HABP0705/Henry_Bautista_PLC4uni/Tarea 2/Diseño de plastico PLC4uni/Diseño parametrico en FreeCad/PLC4uni-209.FCStd

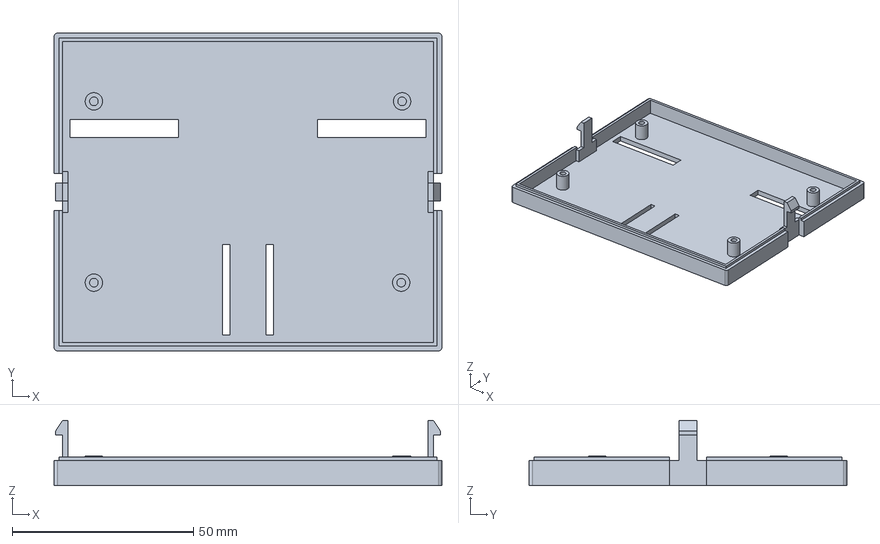
[picture p23: CAD file, 2025-09-25]
Tarea 2/Diseño de plastico PLC4uni/Diseño parametrico en FreeCad/PLC4uni-209.FCStd
107.0 x 87.7 x 18.0 mm
