HABP0705/Henry_Bautista_PLC4uni/Tarea 3/Archivos .DXF/PLC4uni-209.dxf

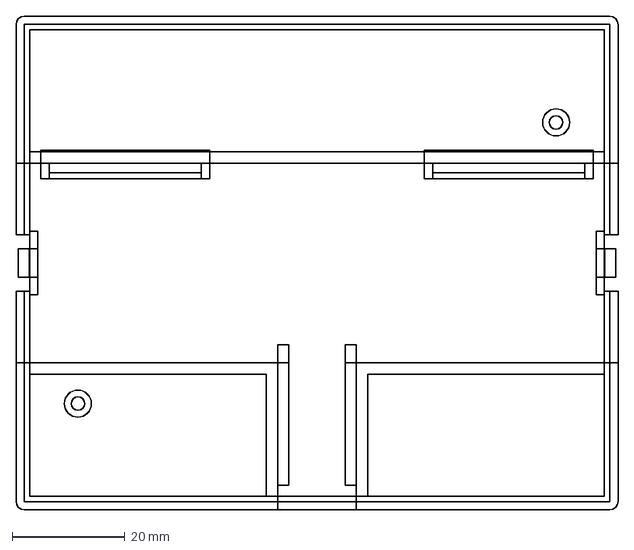
[picture p24: CAD file, 2025-10-06]
Tarea 3/Archivos .DXF/PLC4uni-209.dxf
107.0 x 87.7 mm
