HABP0705/Henry_Bautista_PLC4uni/Tarea 4/1.PCB principal de los conectores/PCB Vertical.DXF

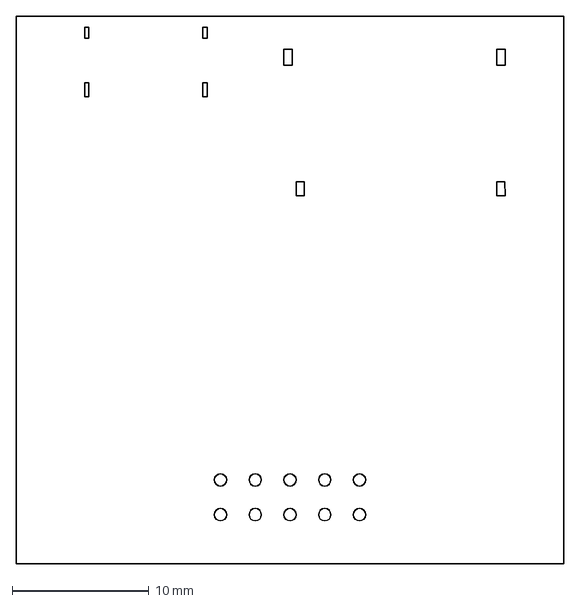
[picture p25: CAD file, 2025-12-02]
Tarea 4/1.PCB principal de los conectores/PCB Vertical.DXF
40.0 x 40.0 mm
