HABP0705/Henry_Bautista_PLC4uni/Tarea 4/2.USB Y SD CARD/USB Type C Port (SMD Type) (1)[1].STEP

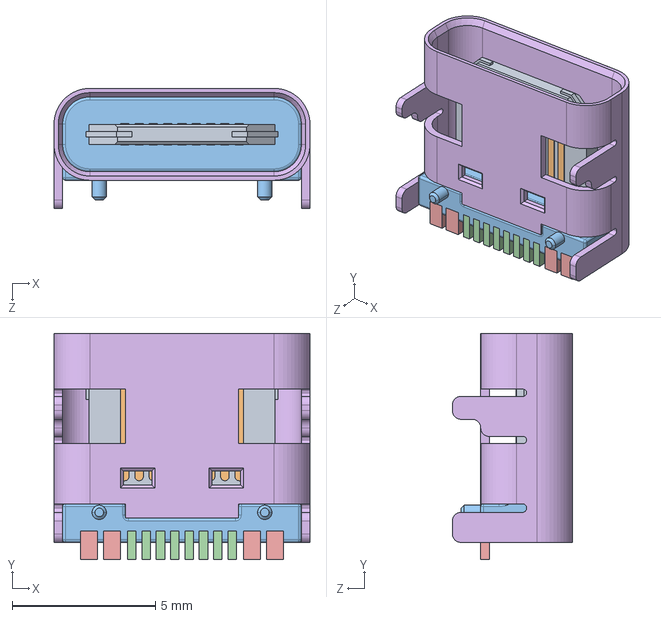
[picture p26: CAD file, 2025-12-02]
Tarea 4/2.USB Y SD CARD/USB Type C Port (SMD Type) (1)[1].STEP
8.94 x 7.90 x 4.20 mm
