HABP0705/Henry_Bautista_PLC4uni/Tarea 6/2.Conector USB y SD Card/Same_Sky_MSD-4-A.step

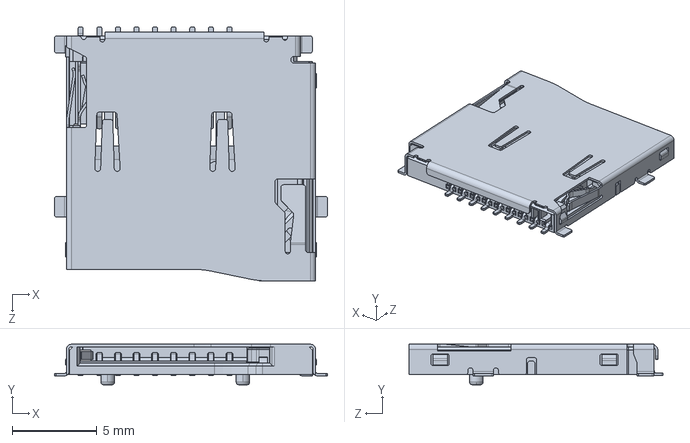
[picture p27: CAD file, 2025-12-02]
Tarea 6/2.Conector USB y SD Card/Same_Sky_MSD-4-A.step
16.1 x 2.40 x 15.0 mm
