HABP0705/Henry_Bautista_PLC4uni/Tarea 2/Diseño de plastico PLC4uni/Diseño parametrico en FreeCad/PLC4uni-208.FCStd

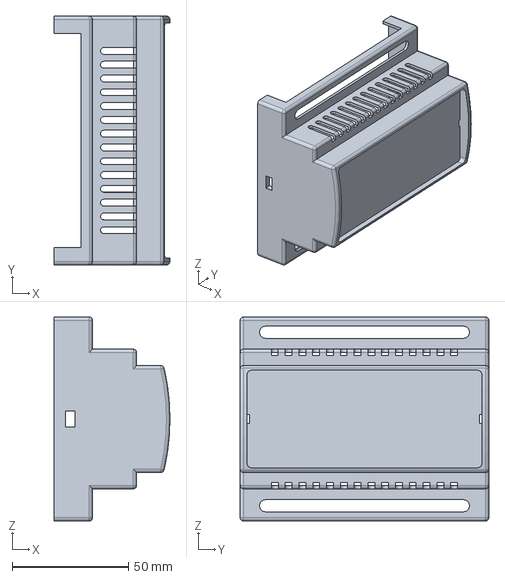
[picture p28: CAD file, 2025-09-24]
Tarea 2/Diseño de plastico PLC4uni/Diseño parametrico en FreeCad/PLC4uni-208.FCStd
49.8 x 107.0 x 87.7 mm
