HABP0705/Henry_Bautista_PLC4uni/Tarea 3/Archivos .DXF/PLC4uni-208.dxf

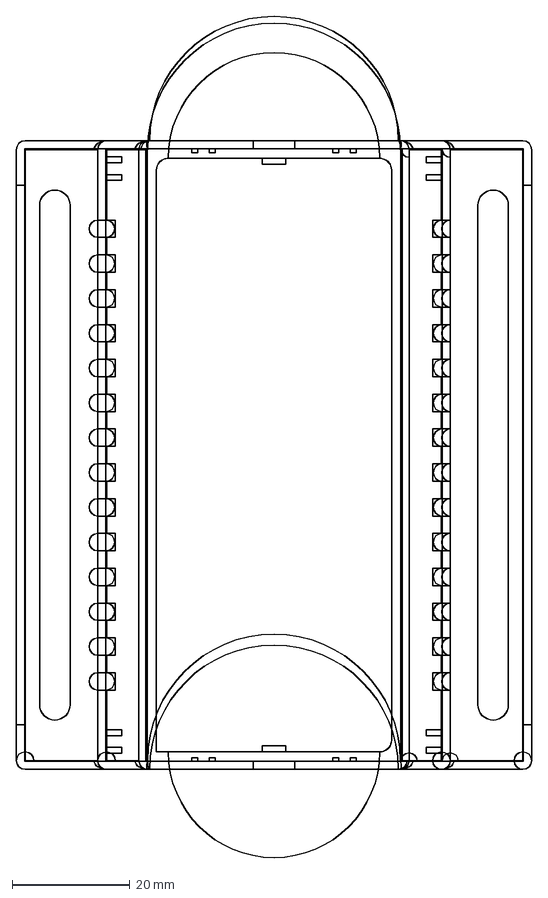
[picture p29: CAD file, 2025-10-06]
Tarea 3/Archivos .DXF/PLC4uni-208.dxf
87.7 x 143.2 mm
