HABP0705/Henry_Bautista_PLC4uni/Tarea 4/1.PCB principal de los conectores/2x5 Male Pin Header Angle.STEP

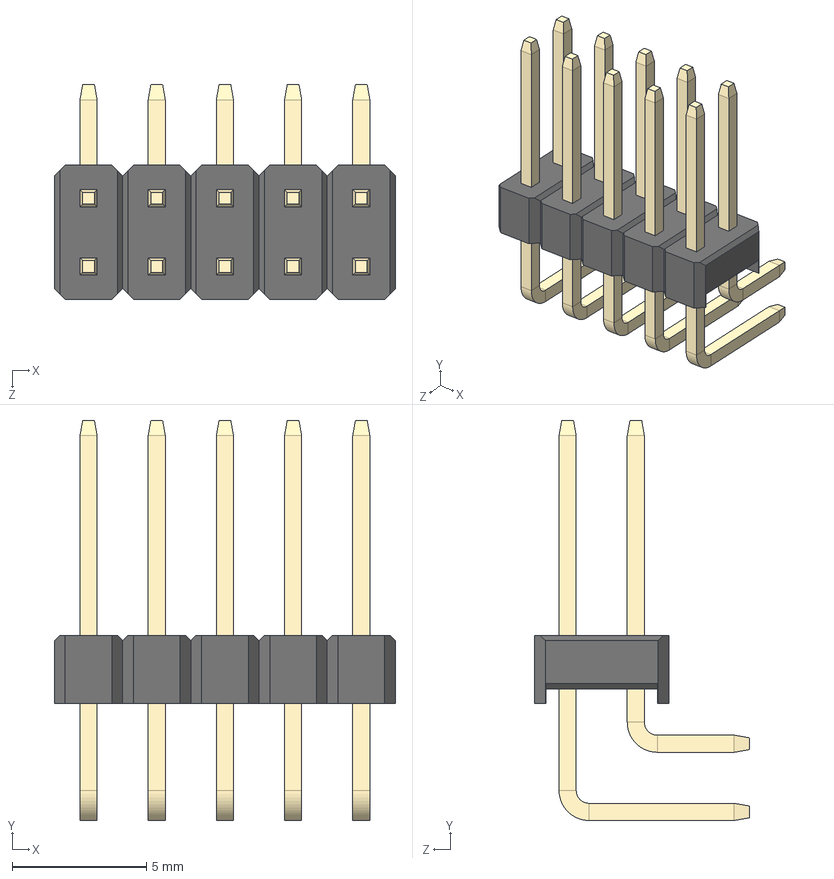
[picture p30: CAD file, 2025-12-02]
Tarea 4/1.PCB principal de los conectores/2x5 Male Pin Header Angle.STEP
12.7 x 14.9 x 8.00 mm
