HABP0705/Henry_Bautista_PLC4uni/Diseño del board/Diseños de circuitos/Diseños de circuitos.kicad_sch

## KiCad design Diseño del board/Diseños de circuitos/Diseños de circuitos.kicad_sch (2025-11-25, an earlier design)

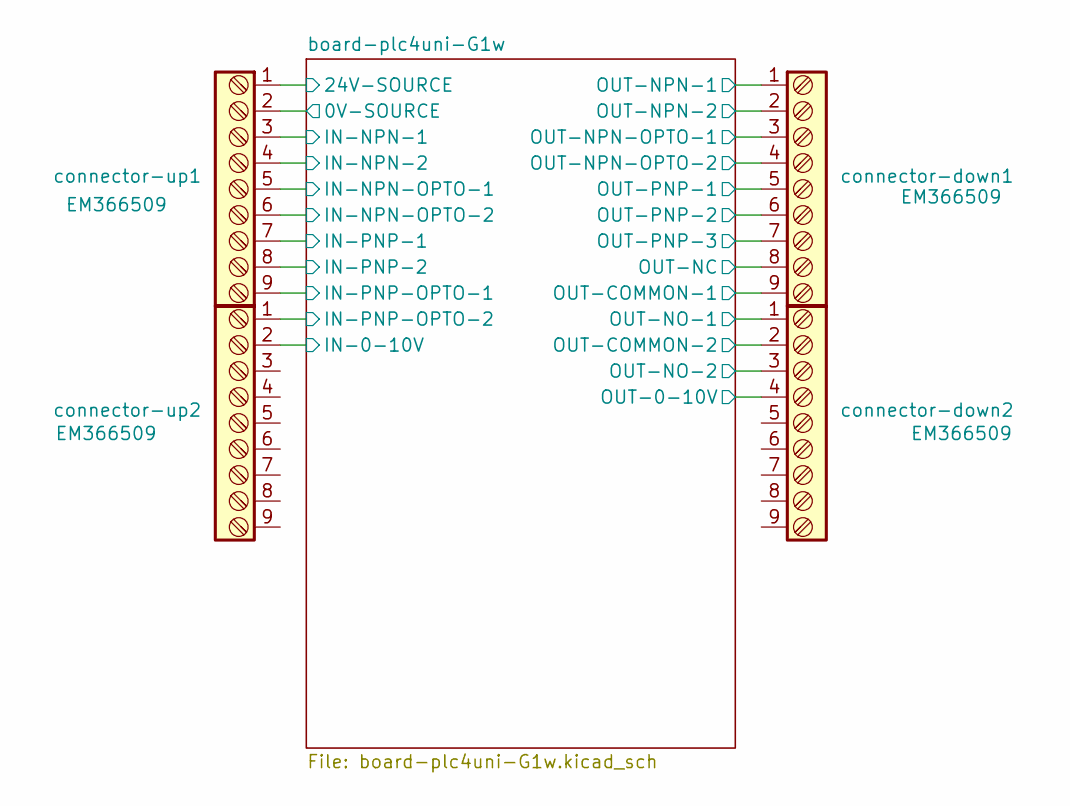
[picture p55: schematic Diseños de circuitos.kicad_sch]

Parts:
connector-down1, connector-down2: Screw_Terminal_9_P5.00mm; TerminalBlock_Phoenix_PT-1,5-9-5.0-H_1x09_P5.00mm_Horizontal; Part number EM366509
connector-up1, connector-up2: Screw_Terminal_9_P5.00mm; TerminalBlock_Phoenix_PT-1,5-9-5.0-H_1x09_P5.00mm_Horizontal; Part number EM366509

Connections:
0V-SOURCE: connector-up1.2
24V-SOURCE: connector-up1.1
IN-0-10V: connector-up2.2
IN-NPN-1: connector-up1.3
IN-NPN-2: connector-up1.4
IN-NPN-OPTO-1: connector-up1.5
IN-NPN-OPTO-2: connector-up1.6
IN-PNP-1: connector-up1.7
IN-PNP-2: connector-up1.8
IN-PNP-OPTO-1: connector-up1.9
IN-PNP-OPTO-2: connector-up2.1
OUT-0-10V: connector-down2.4
OUT-COMMON-1: connector-down1.9
OUT-COMMON-2: connector-down2.2
OUT-NC: connector-down1.8
OUT-NO-1: connector-down2.1
OUT-NO-2: connector-down2.3
OUT-NPN-1: connector-down1.1
OUT-NPN-2: connector-down1.2
OUT-NPN-OPTO-1: connector-down1.3
OUT-NPN-OPTO-2: connector-down1.4
OUT-PNP-1: connector-down1.5
OUT-PNP-2: connector-down1.6
OUT-PNP-3: connector-down1.7
