HABP0705/Henry_Bautista_PLC4uni/Diseño del board/Diseños de circuitos/INPUT-0-10V.kicad_sch

## KiCad design Diseño del board/Diseños de circuitos/INPUT-0-10V.kicad_sch (2025-11-13)

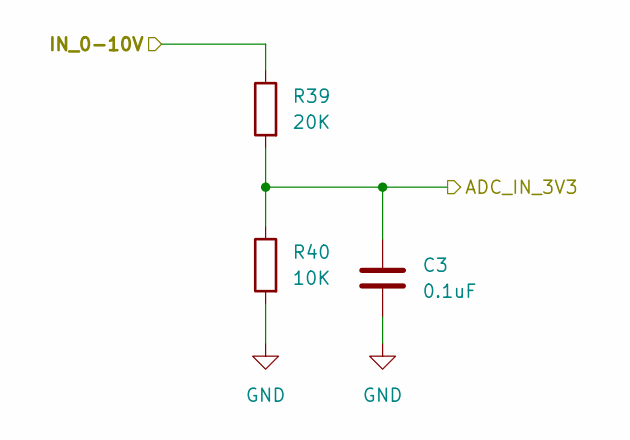
[picture p56: schematic INPUT-0-10V.kicad_sch]

Parts:
C3: 0.1uF; C_0201_0603Metric; LCSC C66501
R39: 20K; R_0603_1608Metric
R40: 10K; R_0603_1608Metric

Connections:
ADC_IN_3V3: C3.2, R39.1, R40.2
GND: C3.1, R40.1
IN_0-10V: R39.2
