HABP0705/Henry_Bautista_PLC4uni/Diseño del board/Diseños de circuitos/output-npn-opto.kicad_sch

## KiCad design Diseño del board/Diseños de circuitos/output-npn-opto.kicad_sch (2025-11-06)

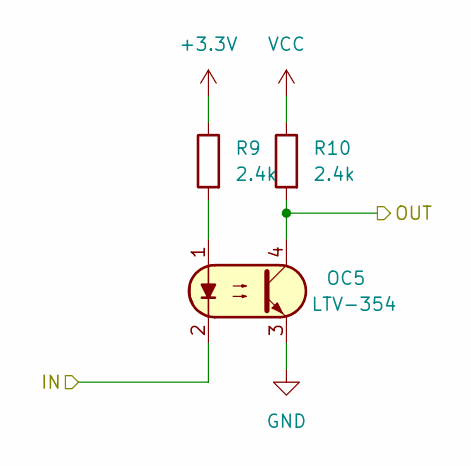
[picture p65: schematic output-npn-opto.kicad_sch]

Parts:
OC5: FOD817S; SMDIP-4_W9.53mm; Part Number LTV-354
R9, R10: 2.4k; R_0603_1608Metric

Connections:
+3.3V: R9.2
GND: OC5.3
IN: OC5.2
unnamed: OC5.1, R9.1
OUT: OC5.4, R10.1
VCC: R10.2
