HABP0705/Henry_Bautista_PLC4uni/Diseño del board/Diseños de circuitos/output-pnp.kicad_sch

## KiCad design Diseño del board/Diseños de circuitos/output-pnp.kicad_sch (2025-11-06)

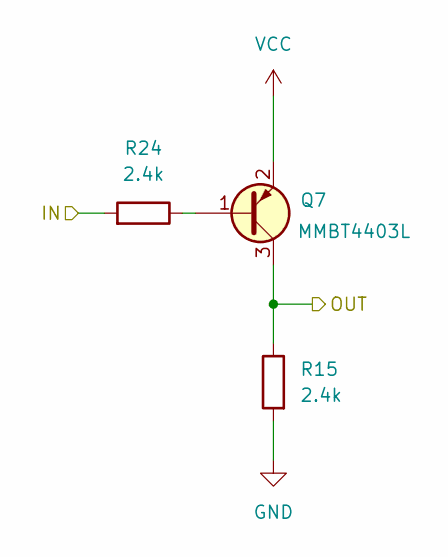
[picture p66: schematic output-pnp.kicad_sch]

Parts:
Q7: 2SA2018; SOT-416; Part number MMBT4403L
R15, R24: 2.4k; R_0603_1608Metric

Connections:
GND: R15.1
IN: R24.1
unnamed: Q7.1 (B), R24.2
OUT: Q7.3 (C), R15.2
VCC: Q7.2 (E)
