HABP0705/Henry_Bautista_PLC4uni/Diseño del board/Diseños de circuitos/source protection.kicad_sch

## KiCad design Diseño del board/Diseños de circuitos/source protection.kicad_sch (2025-11-06)

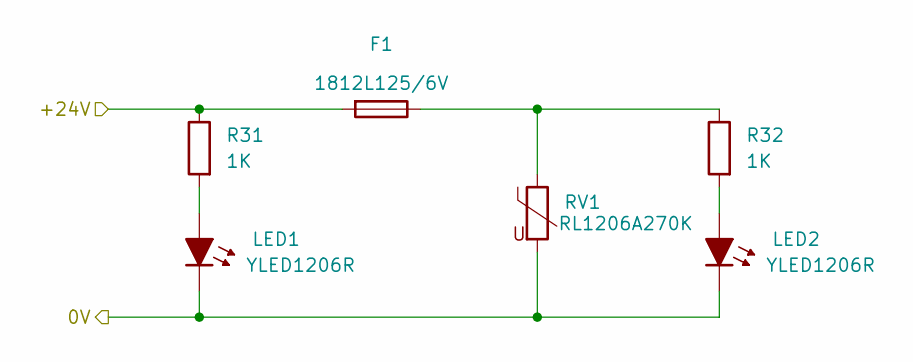
[picture p67: schematic source protection.kicad_sch]

Parts:
F1: Fuse; Fuse_0603_1608Metric; Part number 1812L125/6V
LED1, LED2: LED_1.8mm_SMD; LED_1.8mm_GullWing; Part number YLED1206R
R31, R32: 1K; R_0603_1608Metric
RV1: Varistor; RV_Disc_D7mm_W3.4mm_P5mm; Part number RL1206A270K

Connections:
0V: LED1.1 (K), LED2.1 (K), RV1.2
+24V: F1.2, R31.2
unnamed: F1.1, R32.2, RV1.1
unnamed: LED1.2 (A), R31.1
unnamed: LED2.2 (A), R32.1
