HABP0705/Henry_Bautista_PLC4uni/(commit log)

2025-09-24 tarea 2 realizada
    [PLC4uni-208.FCStd, PLC4uni-209.FCStd]
2025-09-25 realizacion de tarea 2
    [PLC4uni-209.FCStd]
2025-10-06 archivos .dxf e inicio del kidcad
    [PLC4uni-208.dxf, PLC4uni-209.dxf, PLC4uni.kicad_pcb, PLC4uni.kicad_sch]
2025-10-09 arreglo tarea 3
    [PLC4uni.kicad_pcb, PLC4uni.kicad_sch]
2025-11-06 primer diseño
    [Diseños de circuitos.kicad_pcb, Diseños de circuitos.kicad_sch, OUT-NPN-1.kicad_sch, OUT-RELAY-1.kicad_sch, OUT-RELAY-2.kicad_sch, board-plc4uni-G1w.kicad_sch, input-npn-opto.kicad_sch, input-npn.kicad_sch]
2025-11-13 se agrego entrada y salida 0-10V
    [Diseños de circuitos.kicad_pcb, Diseños de circuitos.kicad_sch, INPUT-0-10V.kicad_sch, OUTPUT-0-10V.kicad_sch, board-plc4uni-G1w.kicad_sch, plc4uni-cpu.kicad_sch]
2025-12-02 tarea 4
    [2x5 Male Pin Header Angle.STEP, PCB Vertical.DXF, PLC4uni Ensamble.FCStd, Same_Sky_MSD-4-A.step, USB Type C Port (SMD Type) (1)[1].STEP]
2025-12-11 arreglo tarea 4,5 y tarea 6
    [2x5 Male Pin Header Angle.STEP, PCB Vertical.DXF, PLC4uni Ensamble.FCStd, Same_Sky_MSD-4-A.step, USB Type C Port (SMD Type) (1)[1].STEP]
